Killerpk06/LoRa-Drone-Control/(commit log)

2026-11-04 Add ESP32 LoRa transmitter/receiver firmware and README
    Claude-Session: https://claude.ai/code/session_015iChp7fpVandf1nLuof53n
2026-11-04 Add IEEE report, circuit diagrams, photos and result figures
    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
